altay-brusan/syncbox/(list of files, drawings)

Other design files:
Design/[03] - MICRO CONTROLLER.SchDoc
Design/[08] - CPU USB.SchDoc
Design/Sheet3.SchDoc
Design/Syncbox.PrjPcb
Design/SYNCBOX_V3I1/iMX6 Rex Development Baseboard V1I1_PCB.PcbLib
Design/SYNCBOX_V3I1/SYNCBOX.PcbLib
Design/SYNCBOX_V3I1/SYNCBOX_V3I1.PcbLib
Design/SYNCBOX_V3I1/SYNCBOX_V3I1_1.SCHLIB
