altay-brusan/syncbox/(commit log)

2026-11-02 Add post-V3.1 design updates and missing files
    - Update [03] MICRO CONTROLLER and [08] CPU USB schematics with local
    changes made after the V3.1 release (2021-2022) and the project file
    - Add SYNCBOX_V3I1 library package (SchLib/PcbLib/LibPkg)
    - Add Sheet3.SchDoc scratch sheet (not part of the compiled project)
    - Add COM-Express Technical Manual Design Guide V3 to design guides
    - Add the JTEHM 2020 SyncBox paper PDF
    [SYNCBOX.PcbLib, SYNCBOX_V3I1.PcbLib, SYNCBOX_V3I1_1.SCHLIB, Sheet3.SchDoc, Syncbox.PrjPcb, [03] - MICRO CONTROLLER.SchDoc, [08] - CPU USB.SchDoc, iMX6 Rex Development Baseboard V1I1_PCB.PcbLib]
2026-11-02 Add README with project overview, board features and citation
